xecus/opensource-mri-project/PCB/GradientCoil_transverse/Gradient_Coil v4.dxf

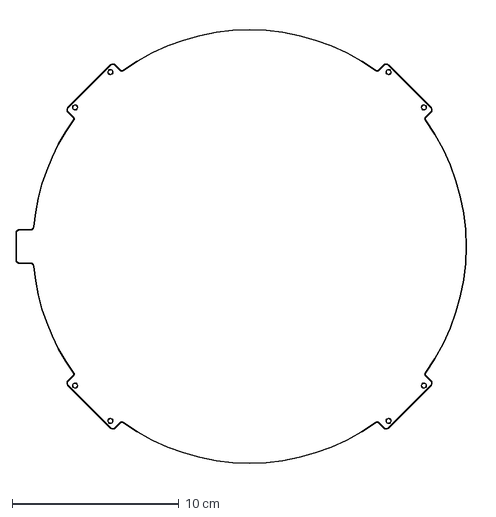
[picture p1: CAD file, 2020-04-10]
PCB/GradientCoil_transverse/Gradient_Coil v4.dxf
27.8 x 27.6 cm
