xecus/opensource-mri-project/PCB/GradientCoil_transverse/Gradient_Coil v3.dxf

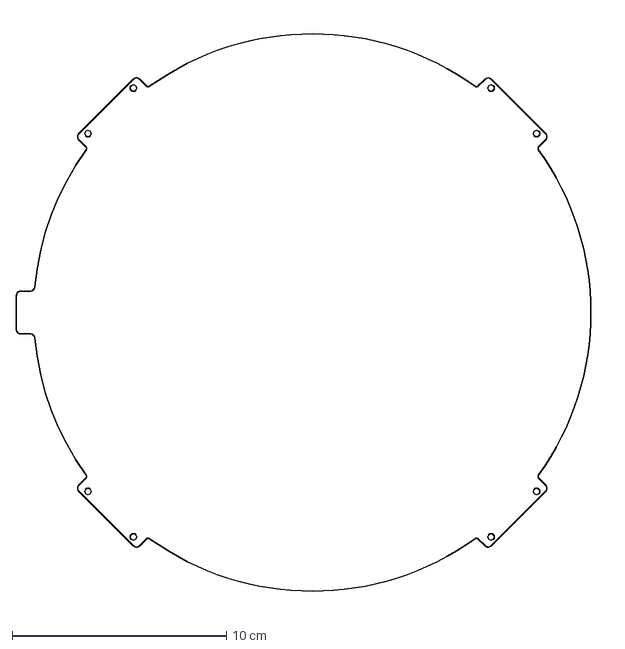
[picture p2: CAD file, 2020-04-10, an earlier design]
PCB/GradientCoil_transverse/Gradient_Coil v3.dxf
27.6 x 27.6 cm
