xecus/opensource-mri-project/(threads)

Thread 2 (2020-03-20):

MRIハードウェア課題

LDshiro, 2020-03-20:
- [ ] 勾配コイルドライバ
　・回路設計とシミュレーション（完了
　・基板設計と発注　（完了
　・部品実装　実施中(80%
　・回路動作検証方法の検討（0%
　・ドライバ回路筐体の設計  (0%

- [ ] メインコイル電流調整用ユニットの開発
   ・筐体の設計　(90%
   ・使用電源の選定と発注（完了
   ・回路設計とシミュレーション　(0%
　・基板設計と発注　（0%

Thread 3 (2020-03-20):

初期のディレクトリ構成の決定

xecus, 2020-03-20:
# WHY

下記、今後増えていく可能性のあるコードベース。
一旦、可能性ベースでまとめて初期のディレクトリ構成をキメる。

- Project Document
  - Portal Site

- Design Document
  - 設計思想等

- Hardware
  - 筐体(3Dプリンティングデータ)

- Software
  - HDL系
  - 制御系
  - 画像再構成系

- SImulations
  - 回路シミュレーション系
  - 物理シミュレーション系

xecus, 2020-03-20:
[FYI]

Project DocumentのPortal Siteは、下記で検討中。
https://github.com/xecus/opensource-mri-project/issues/1

Thread 4 (2020-03-20):

FPGAボードの開発

LDshiro, 2020-03-20:
要求仕様
 今の所は勘で仕様を決定
・16bit ADC 100MSpsのドライブ
・14bit DAC 100MSpsのドライブ
・リアルタイム性
・10M程度のメモリ（あとで詳細検討する

開発フロー
DE0+自作ADC/DACボードで動作検証
↓
FPGA+ADC/DAC搭載ボードの設計
↓
特性測定と基板設計へのフィードバック（1~2サイクル程度
↓
開発完了

Thread 6 (2020-03-30):

RF検出用アンプの開発

LDshiro, 2020-03-30:
##現状
現状で作成している検出アンプはゲイン50倍程度が限度であり、発振防止の為に共振回路に抵抗を直列に入れている。このために、抵抗の熱雑音等でSNRが下がる等の問題を抱えており、最適とは言えない。今回のプロジェクトでは、静磁場が10mTと低い為、検出系に関しては理論値に迫る最適設計が不可欠である。
