xecus/opensource-mri-project/PCB/GradientDriver_rev2/GradientDriver.kicad_pcb

## KiCad design PCB/GradientDriver_rev2/GradientDriver.kicad_pcb (2020-05-16)

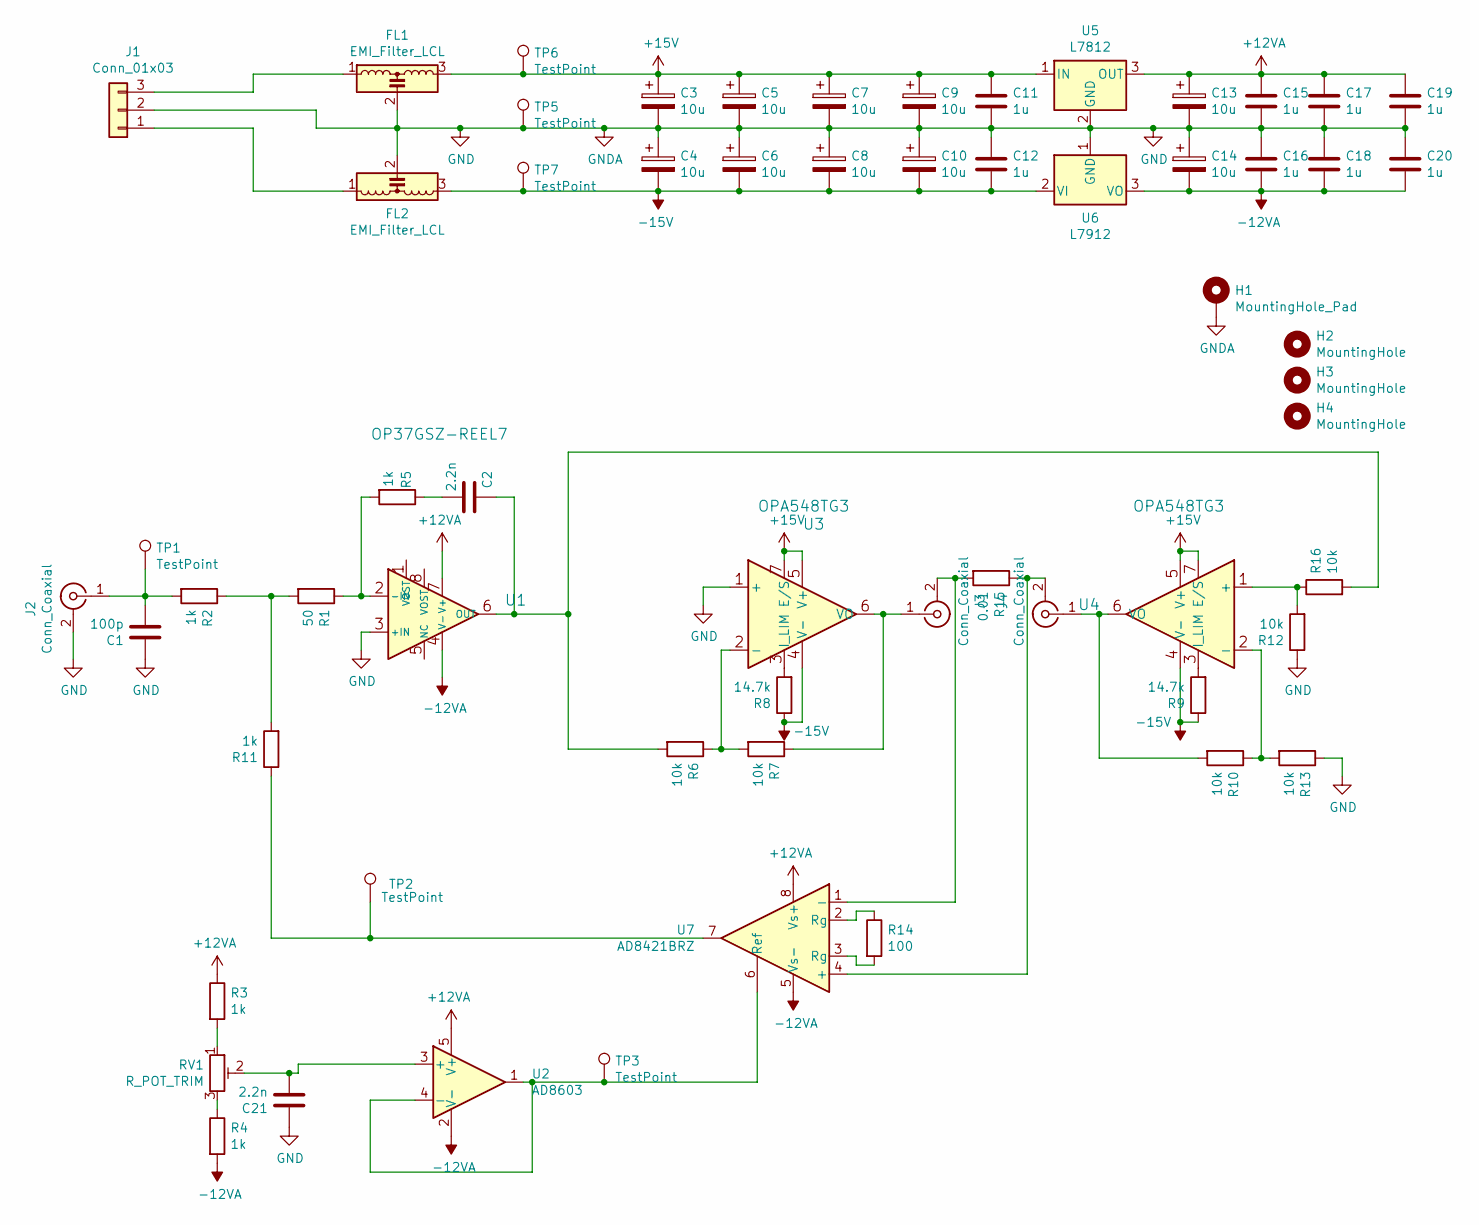
[picture p3: schematic GradientDriver.sch]

Parts:
C1: 100p; C_0603_1608Metric_Pad1.05x0.95mm_HandSolder
C2, C21: 2.2n; C_0603_1608Metric_Pad1.05x0.95mm_HandSolder
C3, C4, C5, C6, C7, C8, C9, C10, C13, C14: 10u; C_Elec_5x5.8
C11, C12, C15, C16, C17, C18, C19, C20: 1u; C_0603_1608Metric_Pad1.05x0.95mm_HandSolder
FL1, FL2: EMI_Filter_LCL; EMI_Filter_2606
H1: MountingHole_Pad; MountingHole_3.2mm_M3_Pad_Via
H2, H3, H4: MountingHole; MountingHole_3.2mm_M3_Pad_Via
J1: Conn_01x03; JST_XH_S3B-XH-A-1_1x03_P2.50mm_Horizontal
J2, J3, J4: Conn_Coaxial; SMA_Samtec_SMA-J-P-X-ST-EM1_EdgeMount
R1: 50; R_0603_1608Metric_Pad1.05x0.95mm_HandSolder
R2, R3, R4, R5, R11: 1k; R_0603_1608Metric_Pad1.05x0.95mm_HandSolder
R6, R7, R10, R12, R13, R16: 10k; R_0603_1608Metric_Pad1.05x0.95mm_HandSolder
R8, R9: 14.7k; R_0603_1608Metric_Pad1.05x0.95mm_HandSolder
R14: 100; R_0603_1608Metric_Pad1.05x0.95mm_HandSolder
R15: 0.01; R_2512_6332Metric_Pad1.52x3.35mm_HandSolder
RV1: R_POT_TRIM; Potentiometer_Bourns_3269W_Vertical
TP1, TP2, TP3, TP5, TP6, TP7: TestPoint; HK-1-G
U1: OP37GSZ-REEL7; SSOP-8_3.9x5.05mm_P1.27mm
U2: AD8603; TSOT-23-5
U3, U4: OPA548TG3
U5: L7812; TO-252-3_TabPin4
U6: L7912; TO-252-3_TabPin4
U7: AD8421BRZ; SOIC-8-1EP_3.9x4.9mm_P1.27mm_EP2.29x3mm

Connections:
+12VA: C13.1, C15.1, C17.1, C19.1, R3.1, U1.7 (V+), U2.5 (V+), U5.3 (OUT), U7.8 (Vs+)
+15V: C3.1, C5.1, C7.1, C9.1, C11.1, FL1.3, TP6.1, U3.5 (V+), U3.7 (E/S), U4.5 (V+), U4.7 (E/S), U5.1 (IN)
-12VA: C14.2, C16.2, C18.2, C20.2, R4.2, U1.4 (V-), U2.2 (V-), U6.3 (VO), U7.5 (Vs-)
-15V: C4.2, C6.2, C8.2, C10.2, C12.2, FL2.3, R8.1, R9.1, TP7.1, U3.4 (V-), U4.4 (V-), U6.2 (VI), U6.4
GND: C1.1, C3.2, C4.1, C5.2, C6.1, C7.2, C8.1, C9.2, C10.1, C11.2, C12.1, C13.2, C14.1, C15.2, C16.1, C17.2, C18.1, C19.2, C20.1, C21.1, FL1.2, FL2.2, H1.1, J1.2, J2.2 (Ext), R12.1, R13.1, TP5.1, U1.3 (+IN), U3.1 (+), U5.2 (GND), U6.1 (GND)
unnamed: C1.2, J2.1 (In), R2.2, TP1.1
unnamed: C2.1, R6.2, R16.2, U1.6 (OUT)
unnamed: C2.2, R5.1
unnamed: C21.2, RV1.2, U2.3 (+)
unnamed: FL1.1, J1.3
unnamed: FL2.1, J1.1
unnamed: J3.1 (In), R7.1, U3.6 (VO)
unnamed: J3.2 (Ext), R15.2, U7.1 (-)
unnamed: J4.1 (In), R10.2, U4.6 (VO)
unnamed: J4.2 (Ext), R15.1, U7.4 (+)
unnamed: R1.1, R5.2, U1.2 (-IN)
unnamed: R1.2, R2.1, R11.2
unnamed: R3.2, RV1.1
unnamed: R4.1, RV1.3
unnamed: R6.1, R7.2, U3.2 (-)
unnamed: R8.2, U3.3 (I_LIM)
unnamed: R9.2, U4.3 (I_LIM)
unnamed: R10.1, R13.2, U4.2 (-)
unnamed: R11.1, TP2.1, U7.7
unnamed: R12.2, R16.1, U4.1 (+)
unnamed: R14.1, U7.2 (Rg)
unnamed: R14.2, U7.3 (Rg)
unnamed: TP3.1, U2.1, U2.4 (-), U7.6 (Ref)

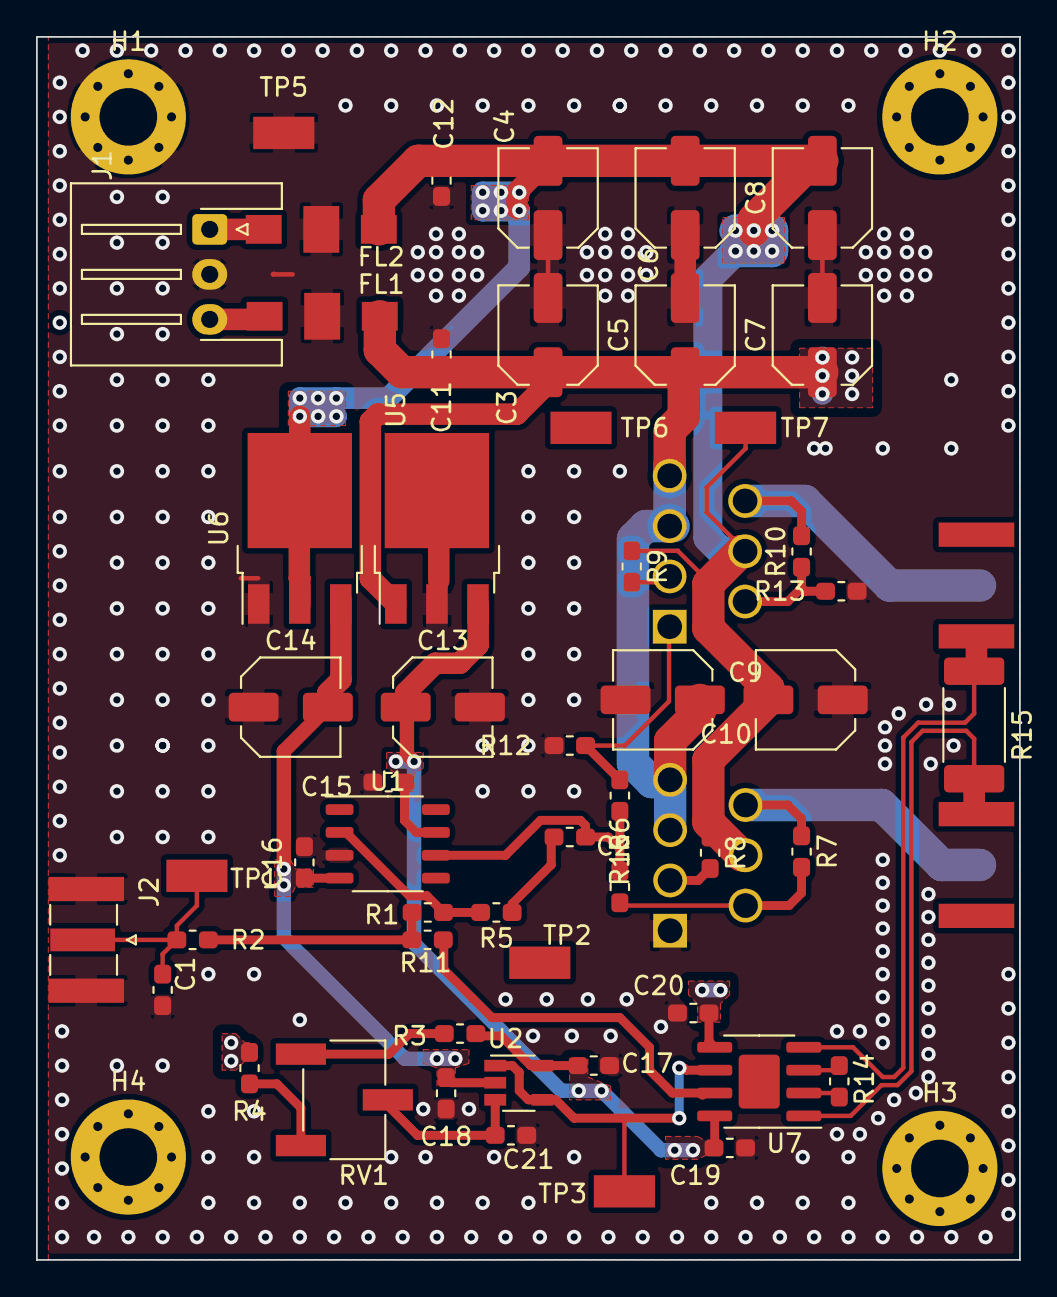
[picture p4: board PCB/GradientDriver_rev2/GradientDriver.kicad_pcb from above]

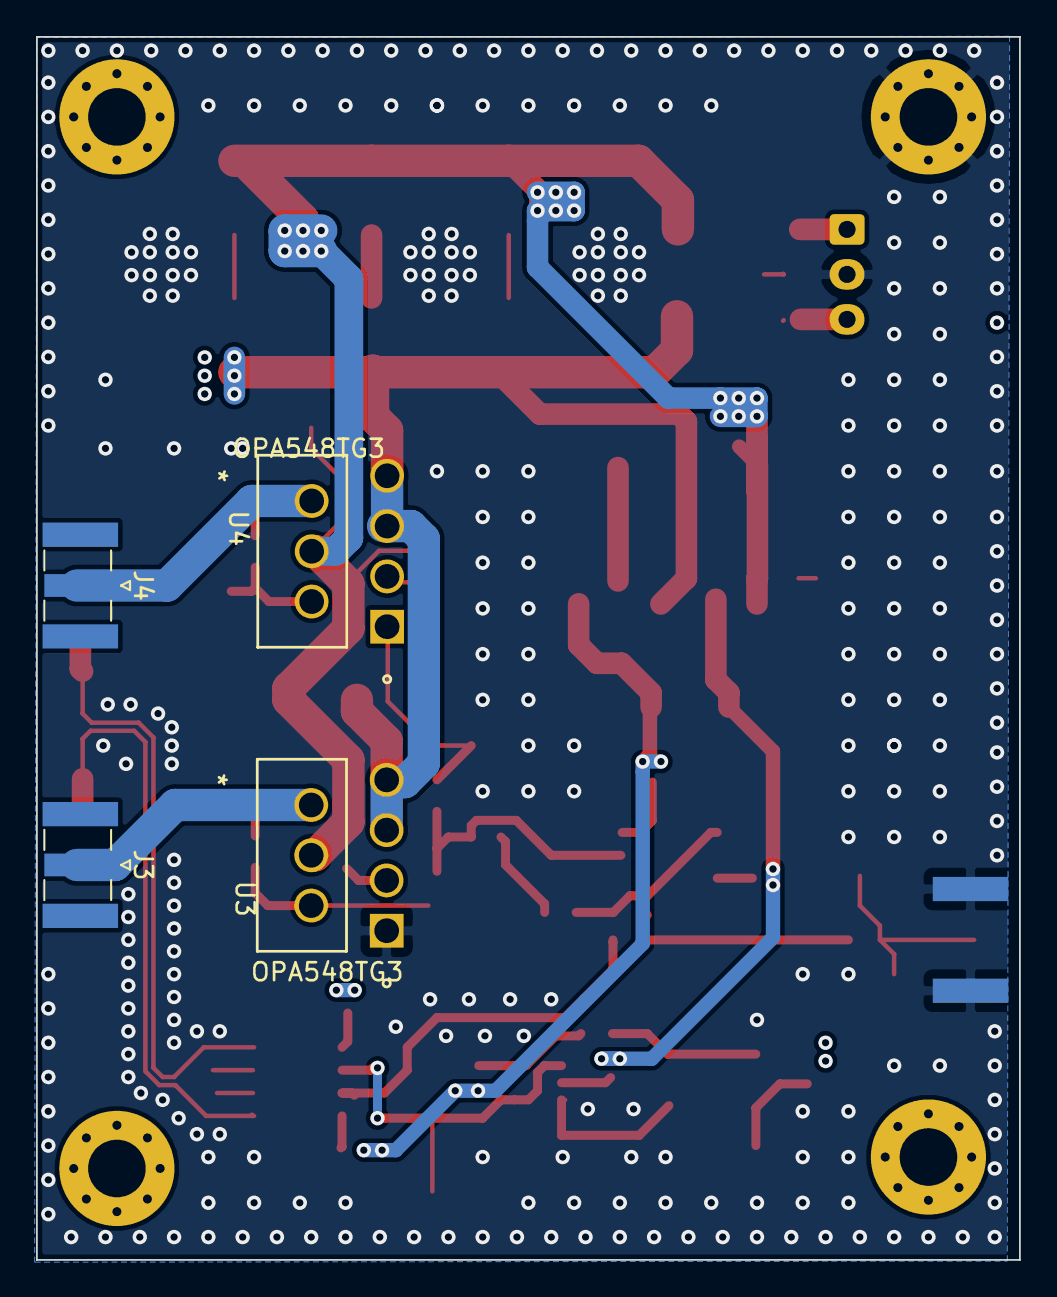
[picture p5: board PCB/GradientDriver_rev2/GradientDriver.kicad_pcb from below]

Board: 4 copper layers, 54.6 x 67.9 mm, 61 parts (4 on the bottom side), 28 nets.
