xecus/opensource-mri-project/PCB/GradientDriver/GradientDriver.kicad_pcb

## KiCad design PCB/GradientDriver/GradientDriver.kicad_pcb (2020-05-16, an earlier design)

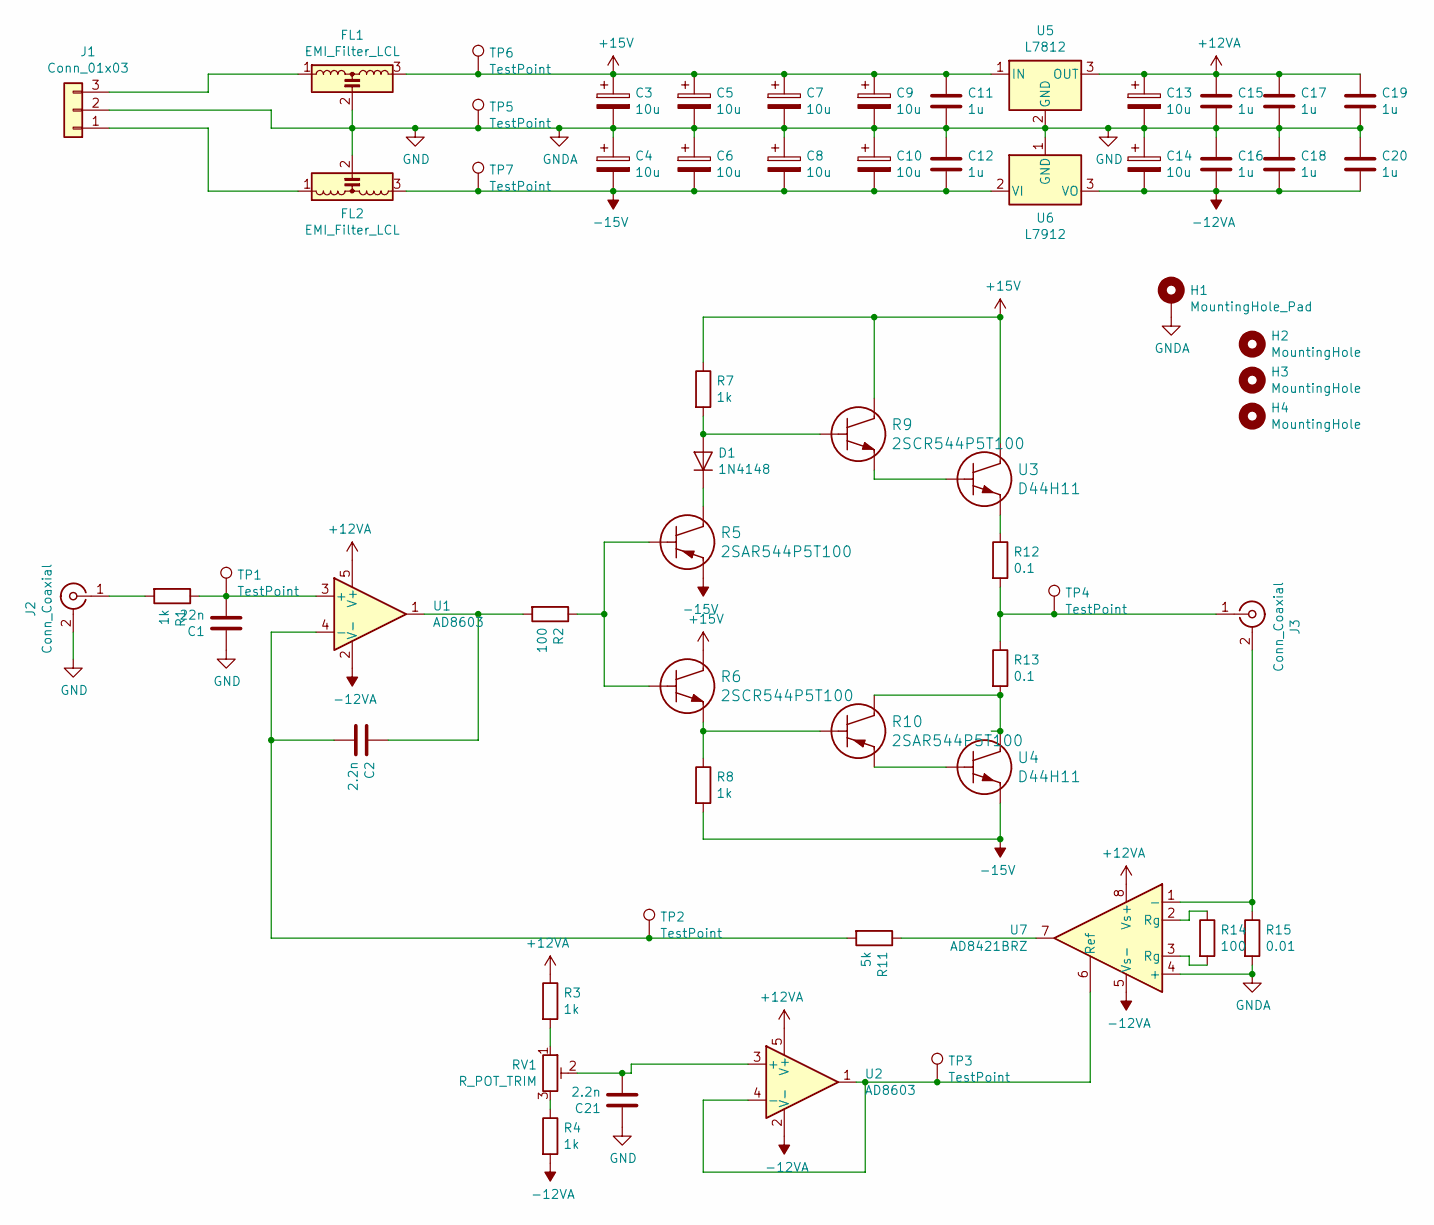
[picture p6: schematic GradientDriver.sch]

Parts:
C1: 22n; C_0603_1608Metric_Pad1.05x0.95mm_HandSolder
C2, C21: 2.2n; C_0603_1608Metric_Pad1.05x0.95mm_HandSolder
C3, C4, C5, C6, C7, C8, C9, C10, C13, C14: 10u; C_Elec_5x5.8
C11, C12, C15, C16, C17, C18, C19, C20: 1u; C_0603_1608Metric_Pad1.05x0.95mm_HandSolder
D1: 1N4148; D_SOD-323_HandSoldering
FL1, FL2: EMI_Filter_LCL; EMI_Filter_2606
H1: MountingHole_Pad; MountingHole_3.2mm_M3_Pad_Via
H2, H3, H4: MountingHole; MountingHole_3.2mm_M3_Pad_Via
J1: Conn_01x03; JST_XH_S3B-XH-A-1_1x03_P2.50mm_Horizontal
J2, J3: Conn_Coaxial; SMA_Samtec_SMA-J-P-X-ST-EM1_EdgeMount
R1, R3, R4, R7, R8: 1k; R_0603_1608Metric_Pad1.05x0.95mm_HandSolder
R2, R14: 100; R_0603_1608Metric_Pad1.05x0.95mm_HandSolder
R5, R10: 2SAR544P5T100; SOT-89-3_Handsoldering
R6, R9: 2SCR544P5T100; SOT-89-3_Handsoldering
R11: 5k; R_0603_1608Metric_Pad1.05x0.95mm_HandSolder
R12, R13: 0.1; TLRH3APTTER100F
R15: 0.01; R_2512_6332Metric_Pad1.52x3.35mm_HandSolder
RV1: R_POT_TRIM; Potentiometer_Bourns_3269W_Vertical
TP1, TP2, TP3, TP4, TP5, TP6, TP7: TestPoint; HK-1-G
U1, U2: AD8603; TSOT-23-5
U3, U4: D44H11
U5: L7812; TO-252-3_TabPin4
U6: L7912; TO-252-3_TabPin4
U7: AD8421BRZ; SOIC-8-1EP_3.9x4.9mm_P1.27mm_EP2.29x3mm

Connections:
+12VA: C13.1, C15.1, C17.1, C19.1, R3.1, U1.5 (V+), U2.5 (V+), U5.3 (OUT), U7.8 (Vs+)
+15V: C3.1, C5.1, C7.1, C9.1, C11.1, FL1.3, R6.2, R7.1, R9.2, TP6.1, U3.2 (C), U5.1 (IN)
-12VA: C14.2, C16.2, C18.2, C20.2, R4.2, U1.2 (V-), U2.2 (V-), U6.3 (VO), U7.5 (Vs-)
-15V: C4.2, C6.2, C8.2, C10.2, C12.2, FL2.3, R5.3, R8.2, TP7.1, U4.3 (E), U6.2 (VI), U6.4
GND: C1.1, C3.2, C4.1, C5.2, C6.1, C7.2, C8.1, C9.2, C10.1, C11.2, C12.1, C13.2, C14.1, C15.2, C16.1, C17.2, C18.1, C19.2, C20.1, C21.1, FL1.2, FL2.2, H1.1, J1.2, J2.2 (Ext), R15.2, TP5.1, U5.2 (GND), U5.4, U6.1 (GND), U7.4 (+)
unnamed: C1.2, R1.1, TP1.1, U1.3 (+)
unnamed: C2.1, R2.2, U1.1
unnamed: C2.2, R11.2, TP2.1, U1.4 (-)
unnamed: C21.2, RV1.2, U2.3 (+)
unnamed: D1.1 (K), R5.2
unnamed: D1.2 (A), R7.2, R9.1
unnamed: FL1.1, J1.3
unnamed: FL2.1, J1.1
unnamed: J2.1 (In), R1.2
unnamed: J3.1 (In), R12.2, R13.1, TP4.1
unnamed: J3.2 (Ext), R15.1, U7.1 (-)
unnamed: R2.1, R5.1, R6.1
unnamed: R3.2, RV1.1
unnamed: R4.1, RV1.3
unnamed: R9.3, U3.1 (B)
unnamed: R6.3, R8.1, R10.1
unnamed: R10.2, R13.2, U4.2 (C)
unnamed: R10.3, U4.1 (B)
unnamed: R11.1, U7.7
unnamed: R12.1, U3.3 (E)
unnamed: R14.1, U7.2 (Rg)
unnamed: R14.2, U7.3 (Rg)
unnamed: TP3.1, U2.1, U2.4 (-), U7.6 (Ref)

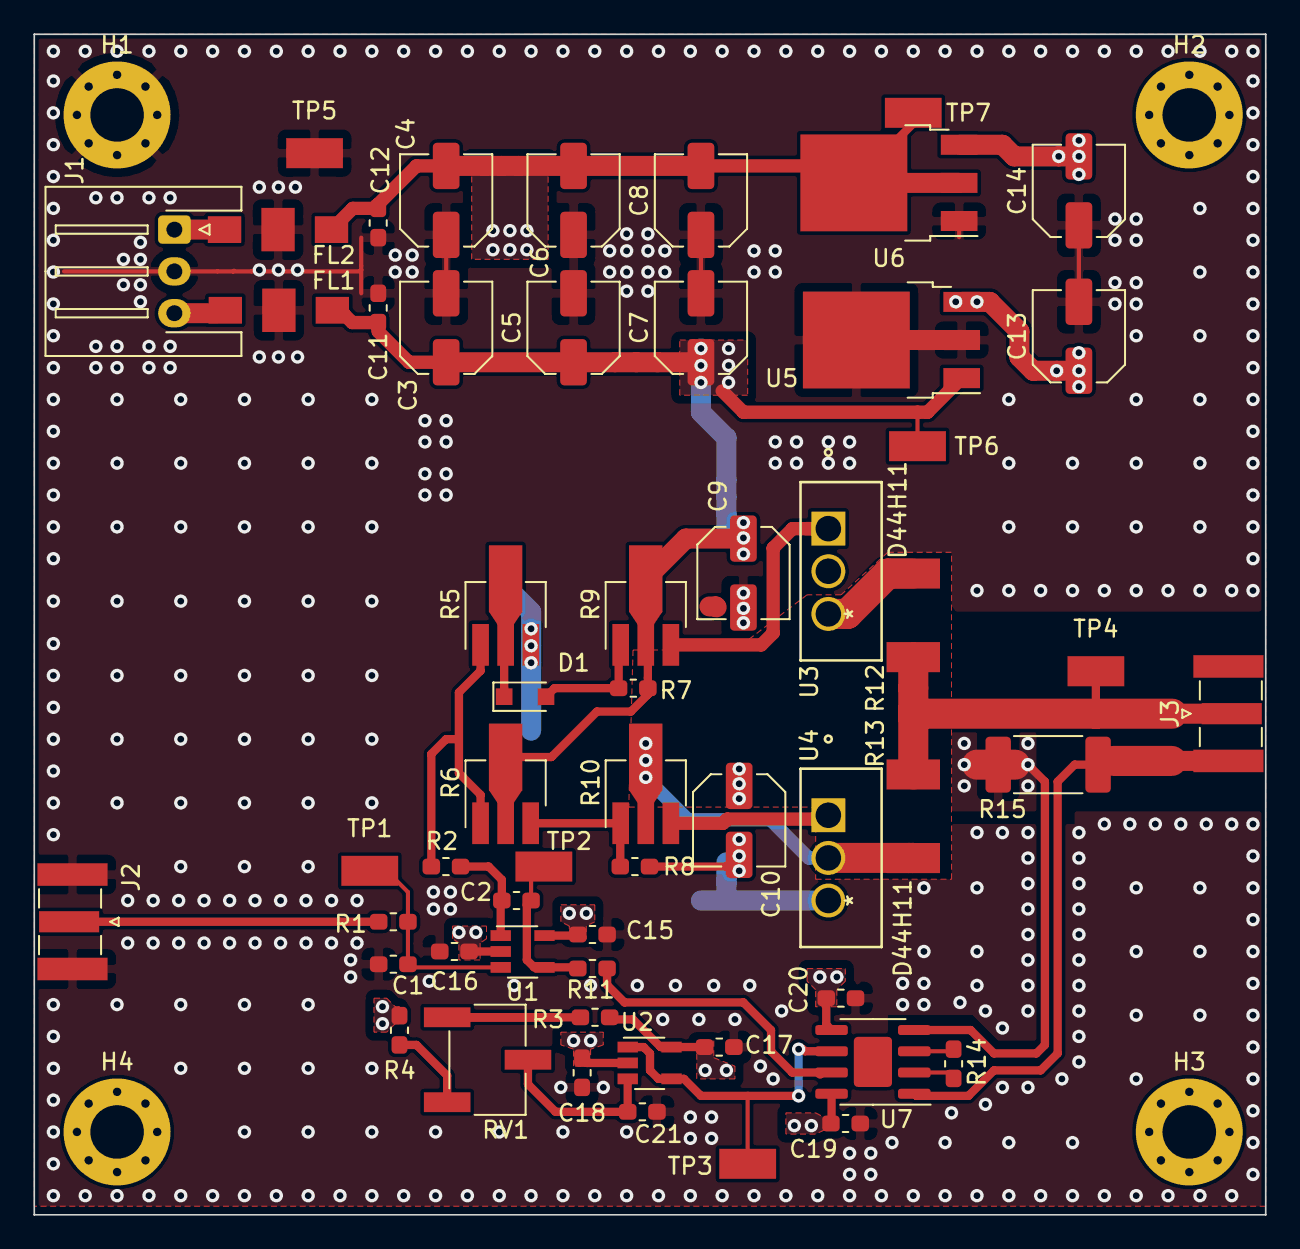
[picture p7: board PCB/GradientDriver/GradientDriver.kicad_pcb from above]

Board: 4 copper layers, 73.7 x 70.6 mm, 61 parts (0 on the bottom side), 28 nets.
