xecus/opensource-mri-project/PCB/Current_Controller/Current_Controller.kicad_pcb

## KiCad design PCB/Current_Controller/Current_Controller.kicad_pcb (2020-05-16)

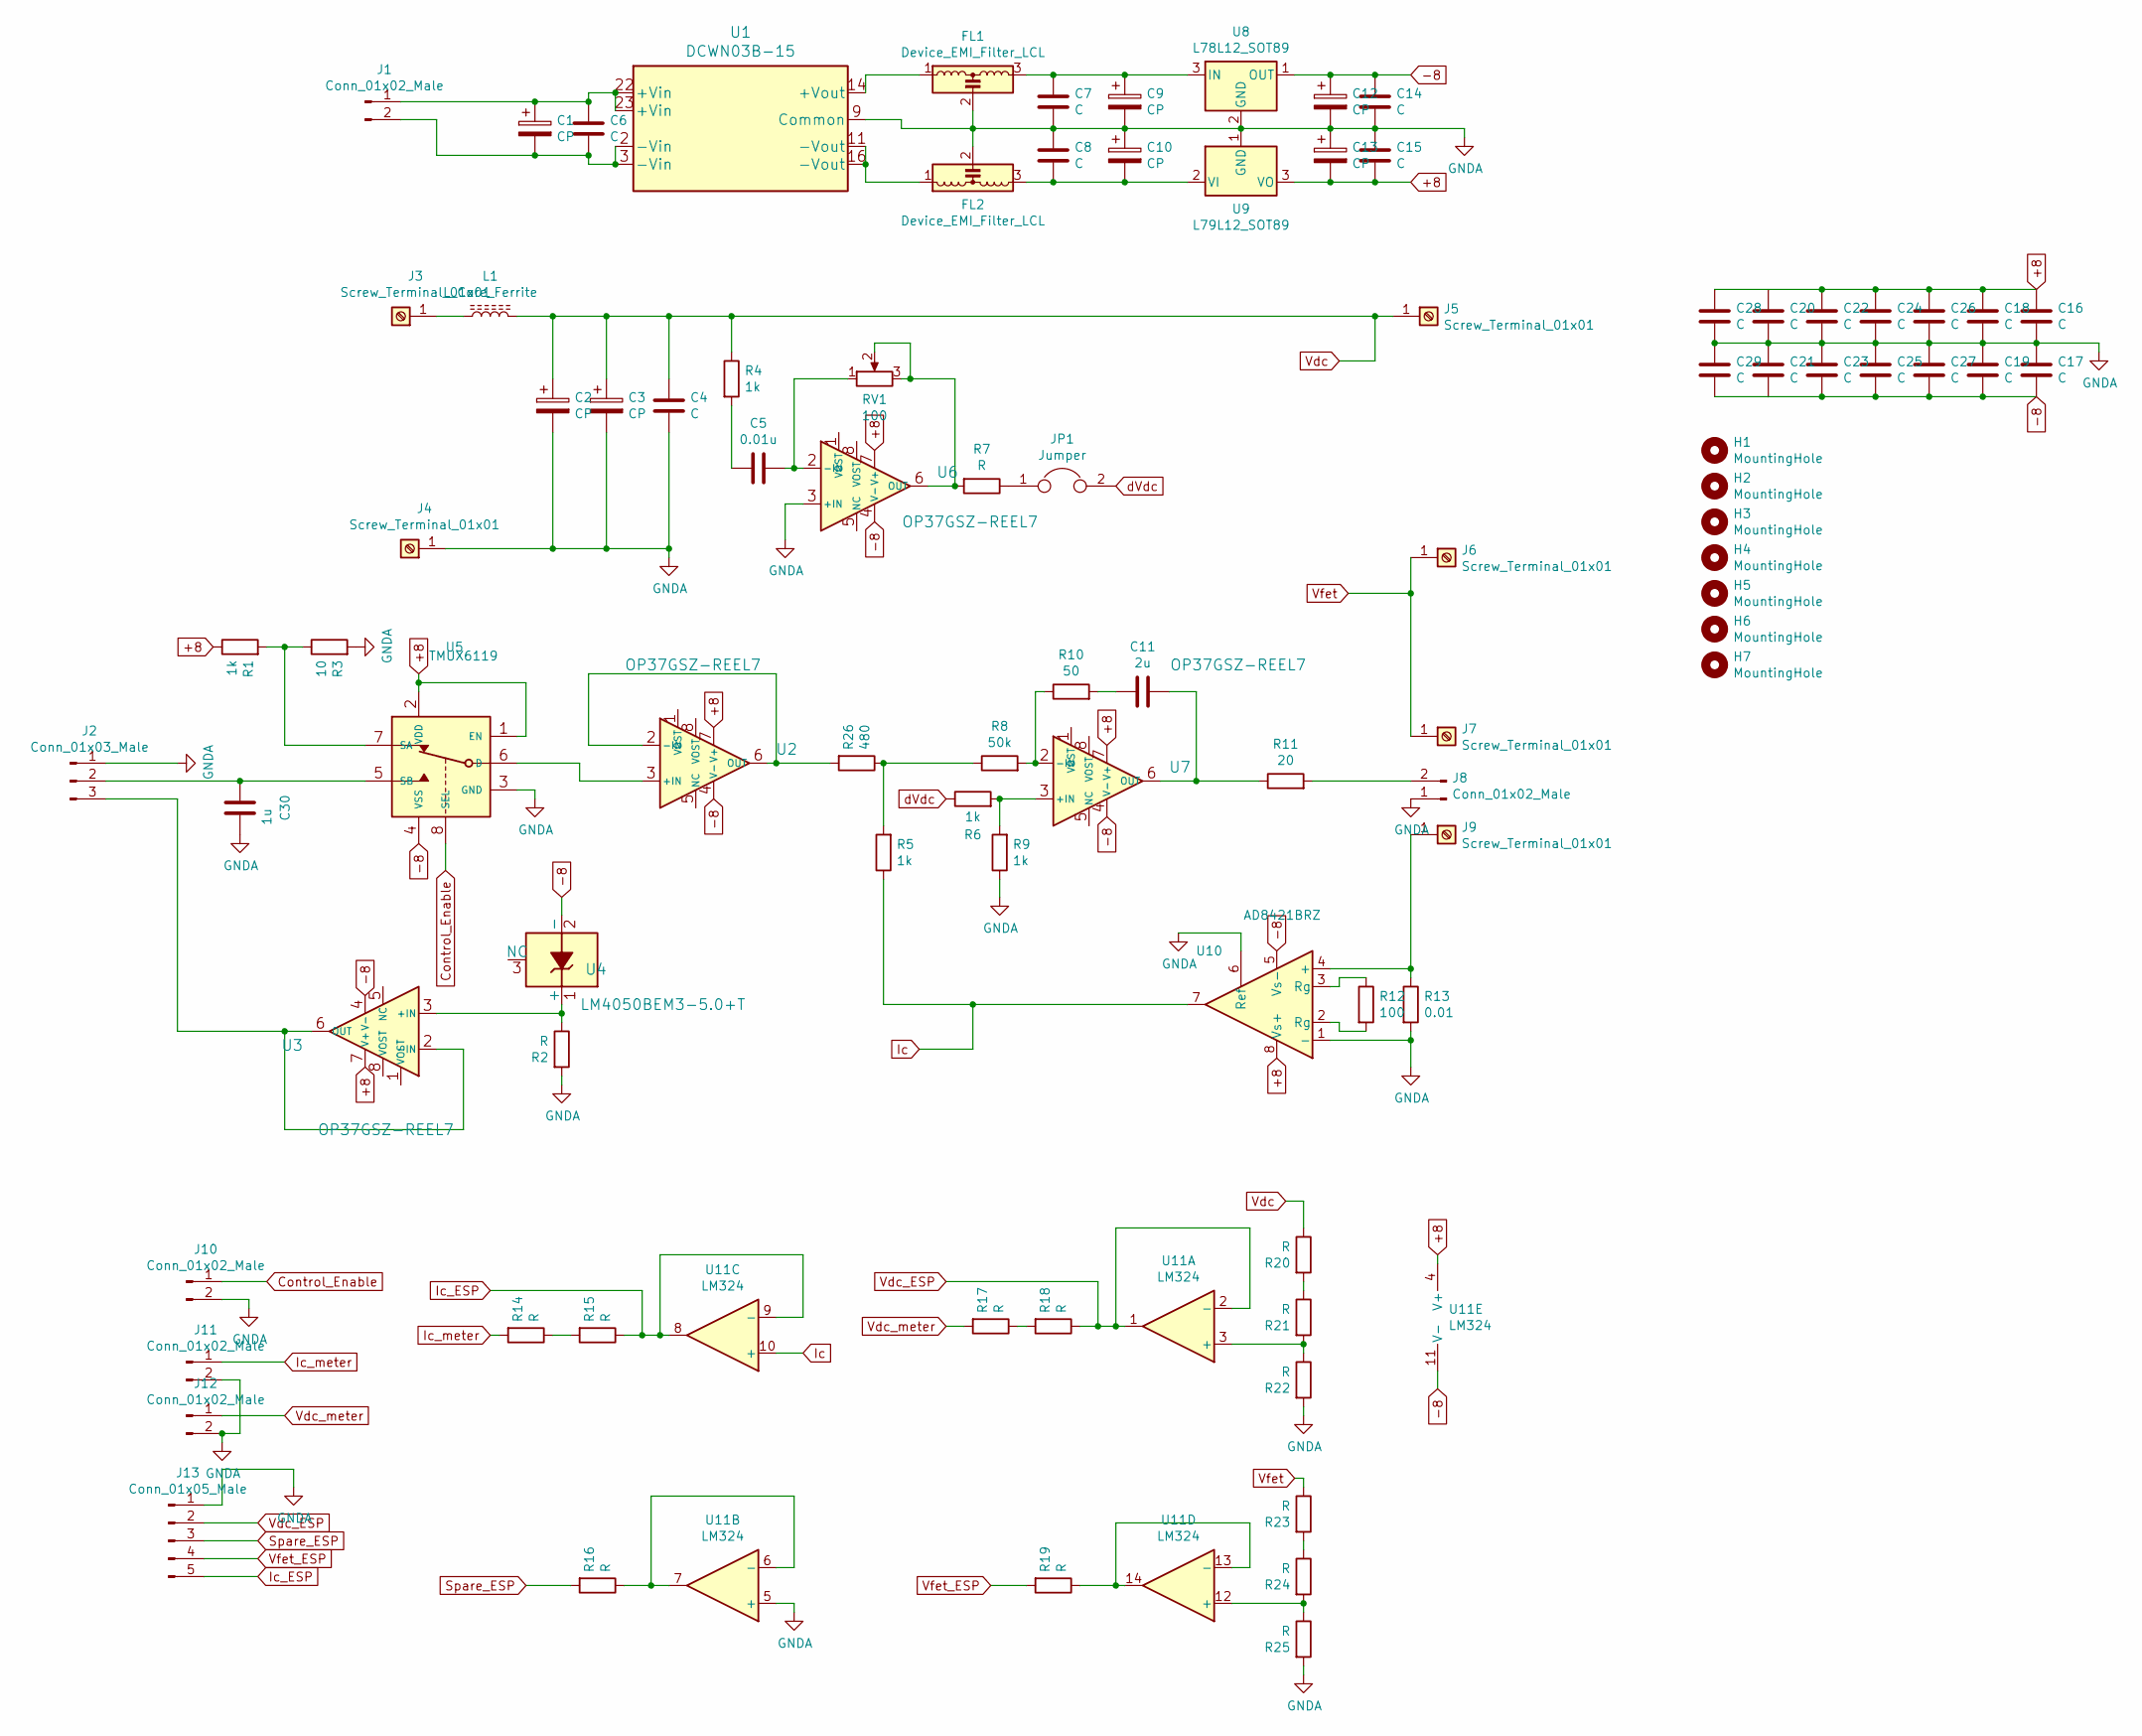
[picture p8: schematic Current_Controller.sch]

Parts:
C1, C9, C10, C12, C13: CP; CP_Elec_5x5.8
C2, C3: CP; CP_Radial_D30.0mm_P10.00mm_SnapIn
C4: C; C_Rect_L10.3mm_W5.7mm_P7.50mm_MKS4
C5: 0.01u; C_0603_1608Metric
C6, C7, C8, C14, C15, C16, C17, C18, C19, C20, C21, C22, C23, C24, C25, C26, C27, C28, C29: C; C_0603_1608Metric
C11: 2u; C_0603_1608Metric
C30: 1u; C_0603_1608Metric
FL1, FL2: Device_EMI_Filter_LCL; EMI_Filter_2606
H1, H2, H3, H4, H5, H6, H7: MountingHole; MountingHole_3.2mm_M3_Pad_Via
J1, J8, J10, J11, J12: Conn_01x02_Male; JST_XH_B2B-XH-AM_1x02_P2.50mm_Vertical
J2: Conn_01x03_Male; JST_XH_B3B-XH-AM_1x03_P2.50mm_Vertical
J3, J4, J5, J6, J7, J9: Screw_Terminal_01x01; keystone_7698
J13: Conn_01x05_Male; JST_XH_B5B-XH-AM_1x05_P2.50mm_Vertical
JP1: Jumper; PinHeader_1x02_P2.54mm_Vertical
L1: L_Core_Ferrite; L_250uH2
R1, R4, R5, R6, R9: 1k; R_0603_1608Metric
R2, R7, R14, R15, R16, R17, R18, R19, R20, R21, R22, R23, R24, R25: R; R_0603_1608Metric
R3: 10; R_0603_1608Metric
R8: 50k; R_0603_1608Metric
R10: 50; R_0603_1608Metric
R11: 20; R_0603_1608Metric
R12: 100; R_0603_1608Metric
R13: 0.01; GMR100HTBFA10L0
R26: 480; R_0603_1608Metric
RV1: 100; Potentiometer_Bourns_3269W_Vertical
U1: DCWN03B-15; DCWN03B-12
U2, U3, U6, U7: OP37GSZ-REEL7; SOIC-8_3.9x4.9mm_P1.27mm
U4: LM4050BEM3-5.0+T; LM4050QBEM3-8.2&slash_NOPB
U5: TMUX6119; SOT-23-8
U8: L78L12_SOT89; SOT-89-3
U9: L79L12_SOT89; SOT-89-3
U10: AD8421BRZ; SOIC-8_3.9x4.9mm_P1.27mm
U11: LM324; TSSOP-14_4.4x5mm_P0.65mm

Connections:
+8: C13.2, C15.1, C16.2, C18.2, C20.2, C22.2, C24.2, C26.2, C28.2, R1.1, U2.7 (V+), U3.7 (V+), U5.1 (EN), U5.2 (VDD), U6.7 (V+), U7.7 (V+), U9.3 (VO), U10.8 (Vs+), U11.4 (V+)
-8: C12.1, C14.2, C17.1, C19.1, C21.1, C23.1, C25.1, C27.1, C29.1, U2.4 (V-), U3.4 (V-), U4.2 (-), U5.4 (VSS), U6.4 (V-), U7.4 (V-), U8.1 (OUT), U10.5 (Vs-), U11.11 (V-)
Control_Enable: J10.1, U5.8 (SEL)
GNDA: C2.2, C3.2, C4.1, C7.1, C8.2, C9.2, C10.1, C12.2, C13.1, C14.1, C15.2, C16.1, C17.2, C18.1, C19.2, C20.1, C21.2, C22.1, C23.2, C24.1, C25.2, C26.1, C27.2, C28.1, C29.2, C30.1, FL1.2, FL2.2, J2.1, J4.1, J8.1, J10.2, J11.2, J12.2, J13.1, R2.2, R3.2, R9.1, R13.2, R22.2, R25.2, U1.9 (Common), U5.3 (GND), U6.3 (+IN), U8.2 (GND), U9.1 (GND), U10.1 (-), U10.6 (Ref), U11.5 (+)
Ic: R5.1, U10.7, U11.10 (+)
Ic_ESP: J13.5, R15.1, U11.8, U11.9 (-)
Ic_meter: J11.1, R14.2
unnamed: C1.1, C6.2, J1.1, U1.22 (+Vin), U1.23 (+Vin)
unnamed: C1.2, C6.1, J1.2, U1.2 (-Vin), U1.3 (-Vin)
unnamed: C5.1, RV1.1, U6.2 (-IN)
unnamed: C5.2, R4.2
unnamed: C7.2, C9.1, FL1.3, U8.3 (IN)
unnamed: C8.1, C10.2, FL2.3, U9.2 (VI)
unnamed: C11.1, R11.1, U7.6 (OUT)
unnamed: C11.2, R10.2
unnamed: C30.2, J2.2, U5.5 (SB)
unnamed: FL1.1, U1.14 (+Vout)
unnamed: FL2.1, U1.11 (-Vout), U1.16 (-Vout)
unnamed: J2.3, U3.2 (-IN), U3.6 (OUT)
unnamed: J3.1, L1.1
unnamed: J8.2, R11.2
unnamed: J9.1, R13.1, U10.4 (+)
unnamed: JP1.1, R7.1
unnamed: R1.2, R3.1, U5.7 (SA)
unnamed: R2.1, U3.3 (+IN), U4.1 (+)
unnamed: R6.2, R9.2, U7.3 (+IN)
unnamed: R7.2, RV1.2, RV1.3, U6.6 (OUT)
unnamed: R8.2, R10.1, U7.2 (-IN)
unnamed: R12.1, U10.3 (Rg)
unnamed: R12.2, U10.2 (Rg)
unnamed: R14.1, R15.2
unnamed: R16.1, U11.6 (-), U11.7
unnamed: R17.1, R18.2
unnamed: R19.1, U11.13 (-), U11.14
unnamed: R20.2, R21.1
unnamed: R21.2, R22.1, U11.3 (+)
unnamed: R23.2, R24.1
unnamed: R24.2, R25.1, U11.12 (+)
unnamed: R5.2, R8.1, R26.1
unnamed: R26.2, U2.2 (-IN), U2.6 (OUT)
unnamed: U2.3 (+IN), U5.6 (D)
Spare_ESP: J13.3, R16.2
Vdc: C2.1, C3.1, C4.2, J5.1, L1.2, R4.1, R20.1
Vdc_ESP: J13.2, R18.1, U11.1, U11.2 (-)
Vdc_meter: J12.1, R17.2
Vfet: J6.1, J7.1, R23.1
Vfet_ESP: J13.4, R19.2
dVdc: JP1.2, R6.1

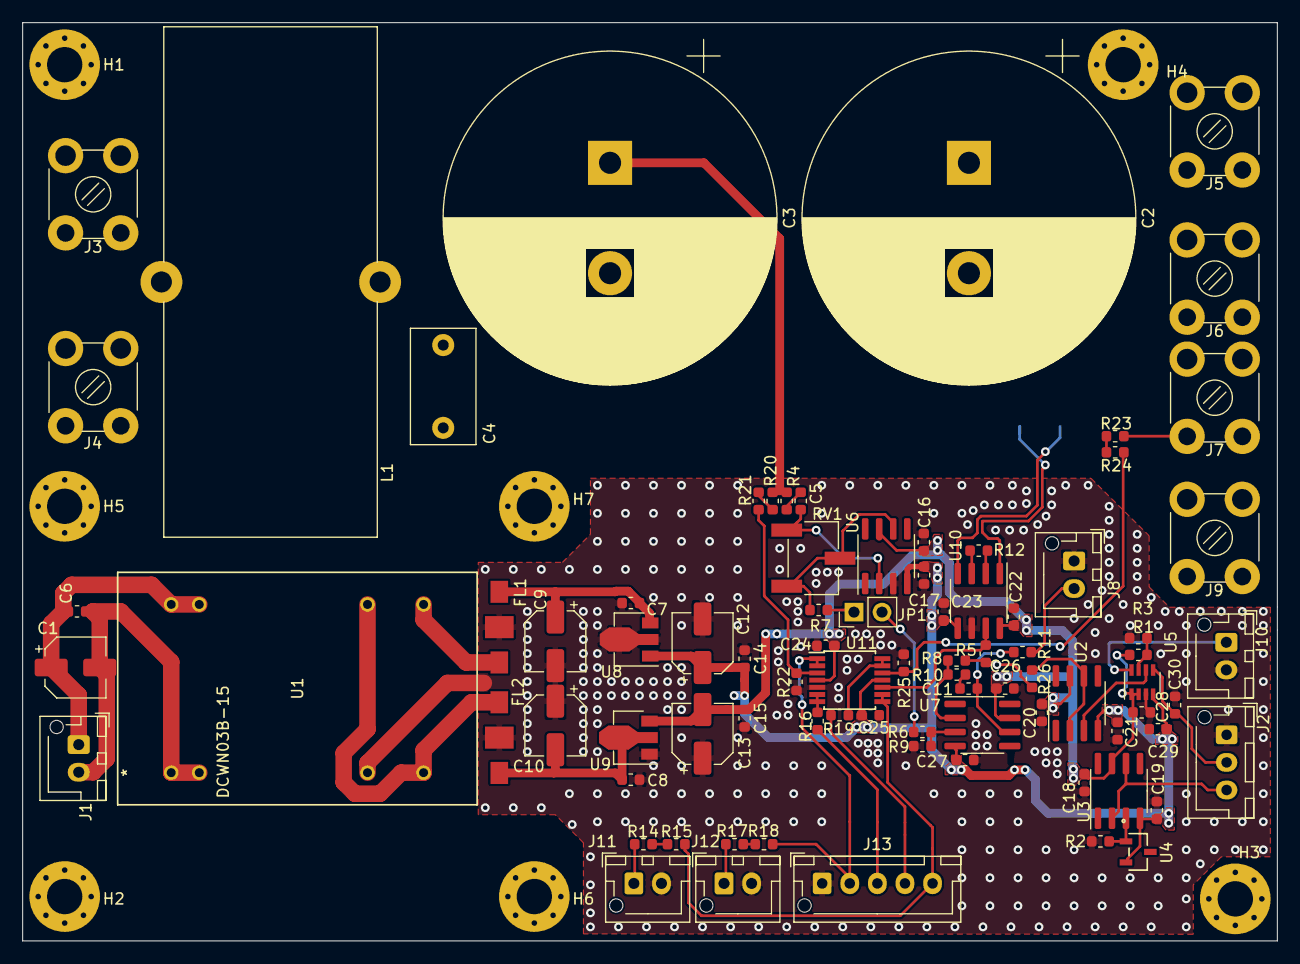
[picture p9: board Current_Controller.kicad_pcb from above]

Board: 2 copper layers, 113.7 x 83.2 mm, 92 parts (1 on the bottom side), 48 nets.
