xecus/opensource-mri-project/PCB/FPGA_sequencer/FPGA_sequencer.kicad_pcb

## KiCad design PCB/FPGA_sequencer/FPGA_sequencer.kicad_pcb (2020-05-16)

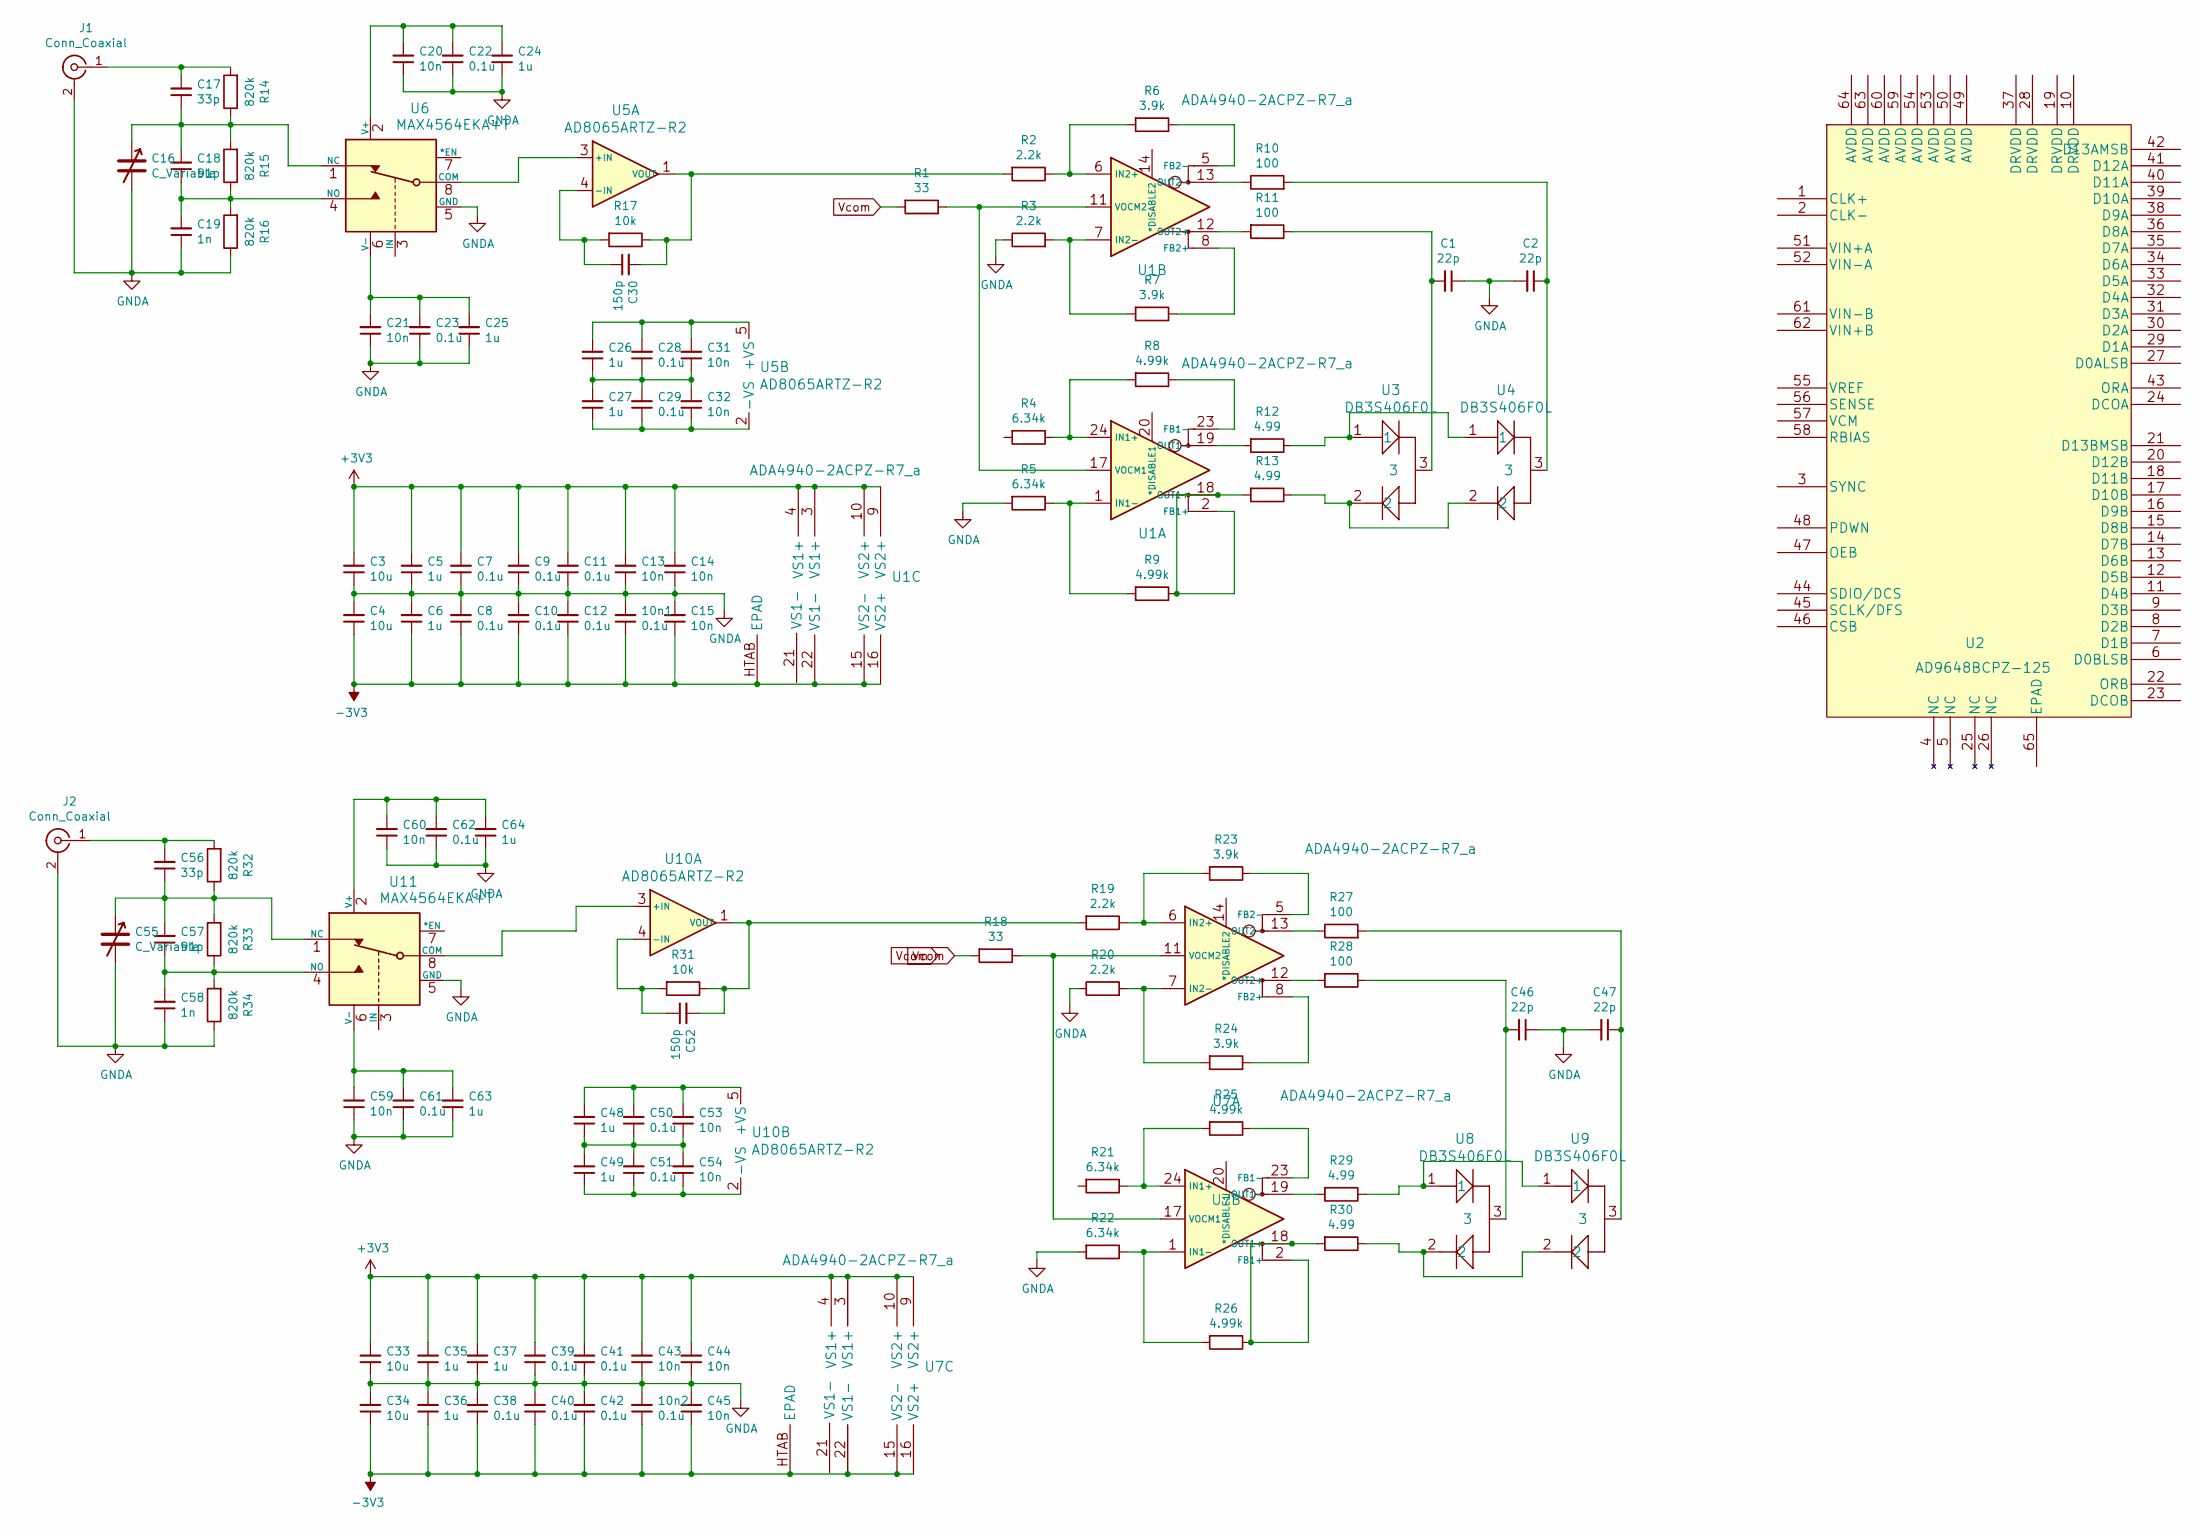
[picture p10: schematic FPGA_sequencer.sch]

Parts:
10n1, 10n2: 0.1u; C_0402_1005Metric
C1, C2, C46, C47: 22p; C_0402_1005Metric
C3, C4, C33, C34: 10u; C_0402_1005Metric
C5, C6, C24, C25, C26, C27, C35, C36, C37, C48, C49, C63, C64: 1u; C_0402_1005Metric
C7, C8, C9, C10, C11, C12, C22, C23, C28, C29, C38, C39, C40, C41, C42, C50, C51, C61, C62: 0.1u; C_0402_1005Metric
C13, C14, C15, C20, C21, C31, C32, C43, C44, C45, C53, C54, C59, C60: 10n; C_0402_1005Metric
C16, C55: C_Variable; C_Trimmer_Murata_TZB4-A
C17, C56: 33p; C_0402_1005Metric
C18, C57: 91p; C_0402_1005Metric
C19, C58: 1n; C_0402_1005Metric
C30, C52: 150p; C_0402_1005Metric
J1, J2: Conn_Coaxial; SMA_Amphenol_132134-11_Vertical
R1, R18: 33; R_0402_1005Metric
R2, R3, R19, R20: 2.2k; R_0402_1005Metric
R4, R5, R21, R22: 6.34k; R_0402_1005Metric
R6, R7, R23, R24: 3.9k; R_0402_1005Metric
R8, R9, R25, R26: 4.99k; R_0402_1005Metric
R10, R11, R27, R28: 100; R_0402_1005Metric
R12, R13, R29, R30: 4.99; R_0402_1005Metric
R14, R15, R16, R32, R33, R34: 820k; R_0402_1005Metric
R17, R31: 10k; R_0402_1005Metric
U1, U7: ADA4940-2ACPZ-R7_a; ADA4940-2ACPZ-R7
U2: AD9648BCPZ-125
U3, U4, U8, U9: DB3S406F0L
U5, U10: AD8065ARTZ-R2
U6, U11: MAX4564EKA+T; MAX4564EKA&plus_T

Connections:
+3V3: C3.2, C5.2, C7.2, C9.2, C11.2, C13.2, C14.2, C33.2, C35.2, C37.2, C39.2, C41.2, C43.2, C44.2, U1.3 (VS1+), U1.4 (VS1+), U1.9 (VS2+), U1.10 (VS2+), U7.3 (VS1+), U7.4 (VS1+), U7.9 (VS2+), U7.10 (VS2+)
-3V3: 10n1.1, 10n2.1, C4.1, C6.1, C8.1, C10.1, C12.1, C15.1, C34.1, C36.1, C38.1, C40.1, C42.1, C45.1, U1.15 (VS2-), U1.16 (VS2+), U1.22 (VS1-), U1.HTAB (EPAD), U7.15 (VS2-), U7.16 (VS2+), U7.22 (VS1-), U7.HTAB (EPAD)
GNDA: 10n1.2, 10n2.2, C1.1, C2.2, C3.1, C4.2, C5.1, C6.2, C7.1, C8.2, C9.1, C10.2, C11.1, C12.2, C13.1, C14.1, C15.2, C16.2, C19.1, C20.1, C21.1, C22.1, C23.1, C24.1, C25.1, C33.1, C34.2, C35.1, C36.2, C37.1, C38.2, C39.1, C40.2, C41.1, C42.2, C43.1, C44.1, C45.2, C46.1, C47.2, C55.2, C58.1, C59.1, C60.1, C61.1, C62.1, C63.1, C64.1, J1.2 (Ext), J2.2 (Ext), R3.1, R5.2, R16.1, R20.1, R22.2, R34.1, U6.5 (GND), U11.5 (GND)
unnamed: C1.2, R11.1, U3.3
unnamed: C2.1, R10.2, U4.3
unnamed: C16.1, C17.1, C18.2, R14.1, R15.2, U6.1 (NC)
unnamed: C17.2, J1.1 (In), R14.2
unnamed: C18.1, C19.2, R15.1, R16.2, U6.4 (NO)
unnamed: C20.2, C22.2, C24.2, U6.2 (V+)
unnamed: C21.2, C23.2, C25.2, U6.6 (V-)
unnamed: C26.1, C27.2, C28.1, C29.2, C31.1, C32.2
unnamed: C26.2, C28.2, C31.2, U5.5 (+VS)
unnamed: C27.1, C29.1, C32.1, U5.2 (-VS)
unnamed: C30.1, R17.2, U5.4 (-IN)
unnamed: C30.2, R2.2, R17.1, U5.1 (VOUT)
unnamed: C46.2, R28.1, U8.3
unnamed: C47.1, R27.2, U9.3
unnamed: C48.1, C49.2, C50.1, C51.2, C53.1, C54.2
unnamed: C48.2, C50.2, C53.2, U10.5 (+VS)
unnamed: C49.1, C51.1, C54.1, U10.2 (-VS)
unnamed: C52.1, R31.2, U10.4 (-IN)
unnamed: C52.2, R19.2, R31.1, U10.1 (VOUT)
unnamed: C55.1, C56.1, C57.2, R32.1, R33.2, U11.1 (NC)
unnamed: C56.2, J2.1 (In), R32.2
unnamed: C57.1, C58.2, R33.1, R34.2, U11.4 (NO)
unnamed: C59.2, C61.2, C63.2, U11.6 (V-)
unnamed: C60.2, C62.2, C64.2, U11.2 (V+)
unnamed: R1.1, U1.11 (VOCM2), U1.17 (VOCM1)
unnamed: R2.1, R6.2, U1.6 (IN2+)
unnamed: R3.2, R7.2, U1.7 (IN2-)
unnamed: R4.1, R8.2, U1.24 (IN1+)
unnamed: R5.1, R9.2, U1.1 (IN1-)
unnamed: R6.1, U1.5 (FB2-)
unnamed: R7.1, U1.8 (FB2+)
unnamed: R8.1, U1.23 (FB1-)
unnamed: R10.1, U1.13 (OUT2-)
unnamed: R11.2, U1.12 (OUT2+)
unnamed: R12.1, U3.1, U4.1
unnamed: R12.2, U1.19 (OUT1-)
unnamed: R13.1, U3.2, U4.2
unnamed: R9.1, R13.2, U1.2 (FB1+), U1.18 (OUT1+)
unnamed: R18.1, U7.11 (VOCM2), U7.17 (VOCM1)
unnamed: R19.1, R23.2, U7.6 (IN2+)
unnamed: R20.2, R24.2, U7.7 (IN2-)
unnamed: R21.1, R25.2, U7.24 (IN1+)
unnamed: R22.1, R26.2, U7.1 (IN1-)
unnamed: R23.1, U7.5 (FB2-)
unnamed: R24.1, U7.8 (FB2+)
unnamed: R25.1, U7.23 (FB1-)
unnamed: R26.1, R30.2, U7.2 (FB1+), U7.18 (OUT1+)
unnamed: R27.1, U7.13 (OUT2-)
unnamed: R28.2, U7.12 (OUT2+)
unnamed: R29.1, U8.1, U9.1
unnamed: R29.2, U7.19 (OUT1-)
unnamed: R30.1, U8.2, U9.2
unnamed: U5.3 (+IN), U6.8 (COM)
unnamed: U10.3 (+IN), U11.8 (COM)
Vcom: R1.2, R18.2

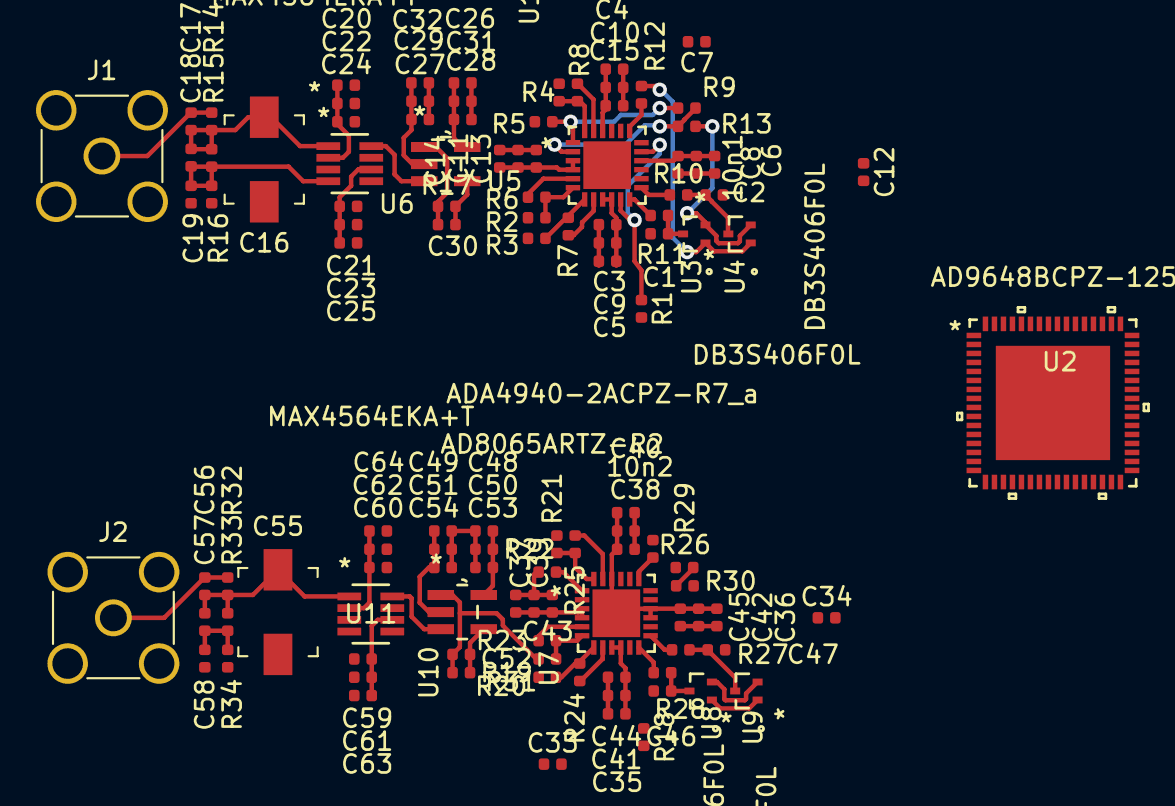
[picture p11: board FPGA_sequencer.kicad_pcb from above]

Board: 2 copper layers, 113 parts (0 on the bottom side), 58 nets.
