xecus/opensource-mri-project/PCB/Detector_rev2/Detector_rev2.kicad_pcb

## KiCad design PCB/Detector_rev2/Detector_rev2.kicad_pcb (2020-04-16)

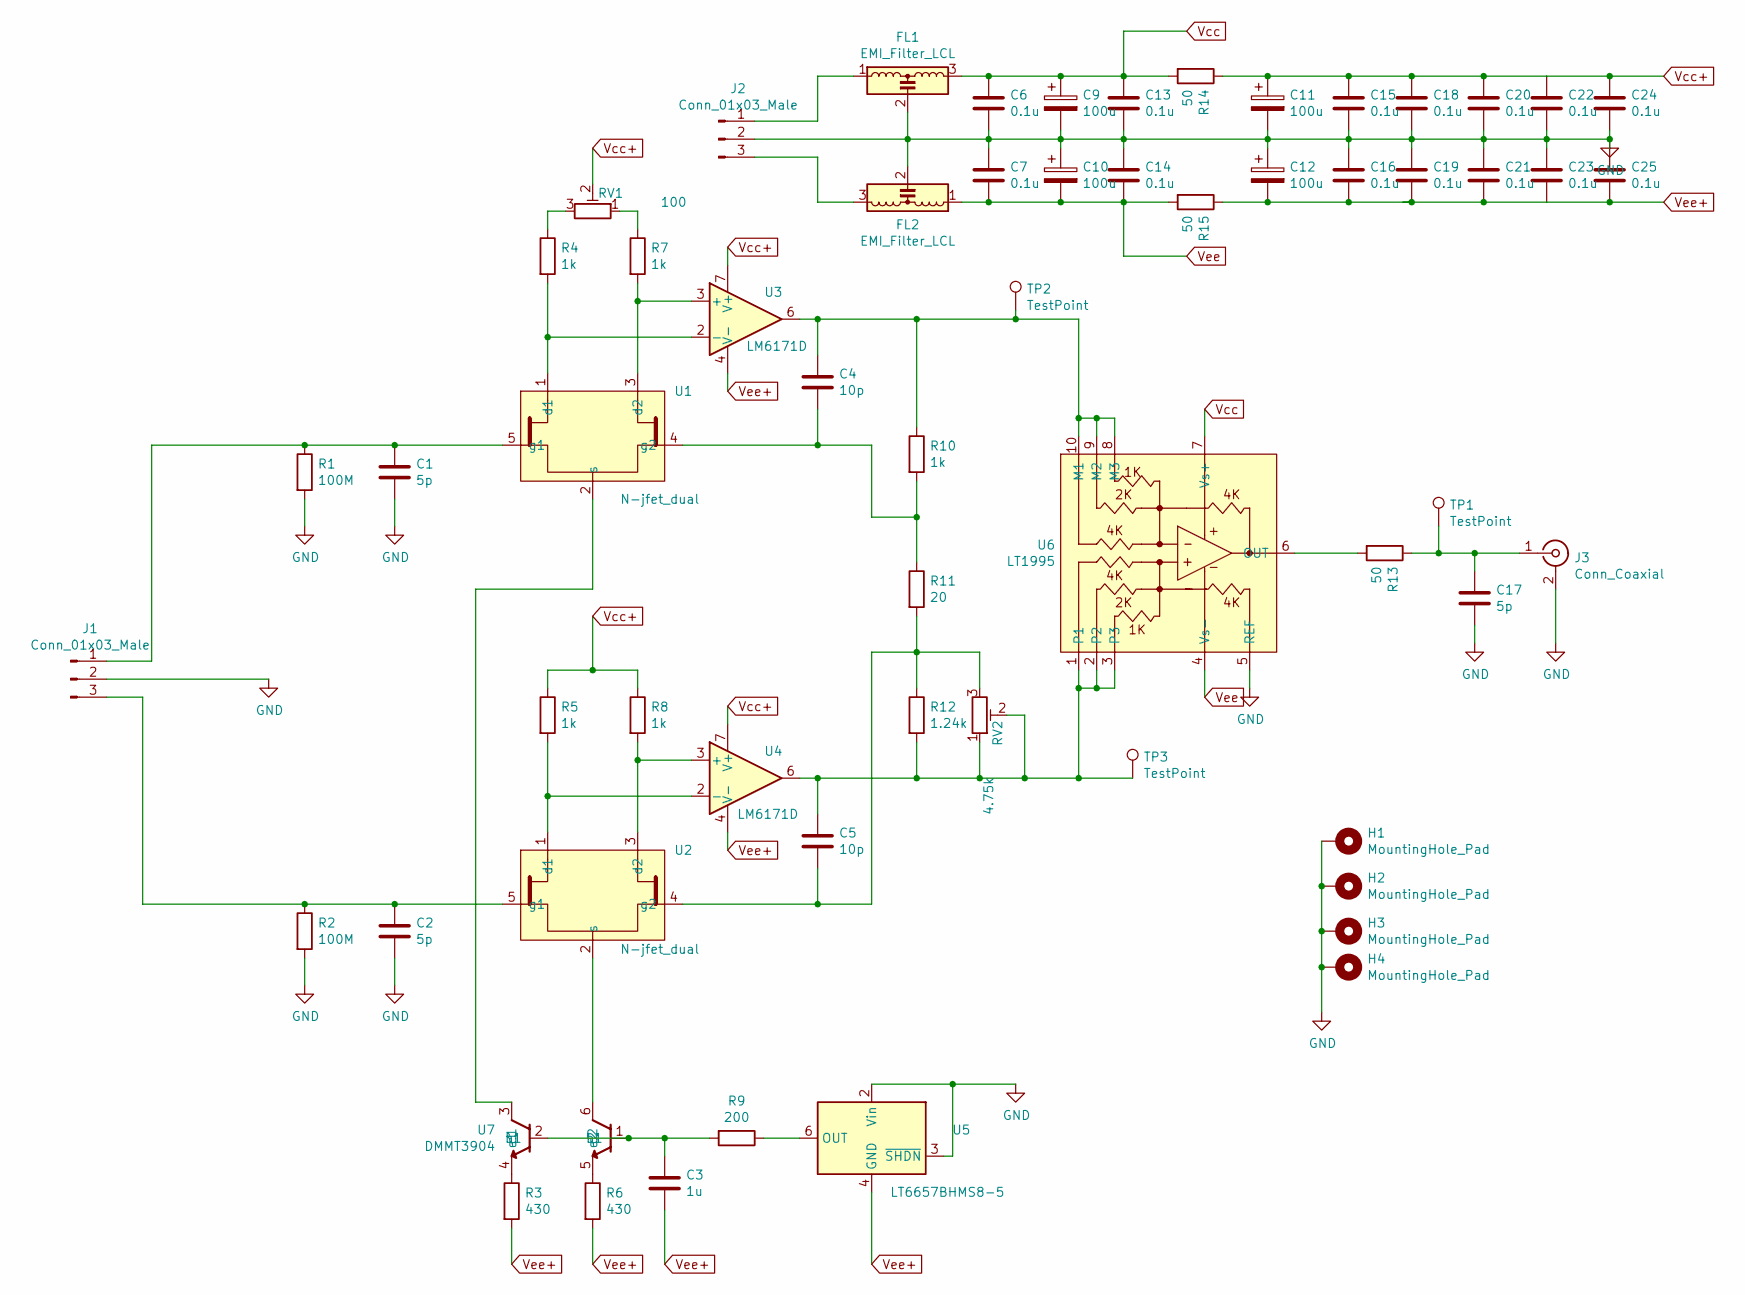
[picture p12: schematic Detector_rev2.sch]

Parts:
C1, C2, C17: 5p; C_0603_1608Metric
C3: 1u; C_0603_1608Metric
C4, C5: 10p; C_0603_1608Metric
C6, C7, C13, C14, C15, C16, C18, C19, C20, C21, C22, C23, C24, C25: 0.1u; C_0603_1608Metric
C9, C10, C11, C12: 100u; C_Elec_5x5.8
FL1, FL2: EMI_Filter_LCL; EMI_Filter_2606
H1, H2, H3, H4: MountingHole_Pad; MountingHole_2.7mm_Pad_Via
J1: Conn_01x03_Male; input
J2: Conn_01x03_Male; JST-XH_S3B
J3: Conn_Coaxial; SMA_Amphenol_132134_Vertical
R1, R2: 100M; R_0603_1608Metric
R3, R6: 430; R_0603_1608Metric
R4, R5, R7, R8, R10: 1k; R_0603_1608Metric
R9: 200; R_0603_1608Metric
R11: 20; R_0603_1608Metric
R12: 1.24k; R_0603_1608Metric
R13, R14, R15: 50; R_0603_1608Metric
RV1: 100; Potentiometer_Bourns_3269W_Vertical
RV2: 4.75k; Potentiometer_Bourns_3269W_Vertical
TP1, TP2, TP3: TestPoint; HK-1-G
U1, U2: N-jfet_dual; SOT_25
U3, U4: LM6171D; SOIC-8_3.9x4.9mm_P1.27mm
U5: LT6657BHMS8-5; MSOP-8_3x3mm_P0.65mm
U6: LT1995; MSOP-10_3x3mm_P0.5mm
U7: DMMT3904; SOT-363_SC-70-6

Connections:
GND: C1.2, C2.2, C6.2, C7.1, C9.2, C10.1, C11.2, C12.1, C13.2, C14.1, C15.2, C16.1, C17.2, C18.2, C19.1, C20.2, C21.1, C22.2, C23.1, C24.2, C25.1, FL1.2, FL2.2, H1.1, H2.1, H3.1, H4.1, J1.2, J2.2, J3.2 (Ext), R1.2, R2.2, U5.2 (Vin), U5.3 (~SHDN), U6.5 (REF)
unnamed: C1.1, J1.1, R1.1, U1.5 (g1)
unnamed: C2.1, J1.3, R2.1, U2.5 (g1)
unnamed: C3.2, R9.2, U7.1 (b1), U7.2 (b1)
unnamed: C4.1, R10.1, TP2.1, U3.6, U6.8 (M3), U6.9 (M2), U6.10 (M1)
unnamed: C4.2, R10.2, R11.1, U1.4 (g2)
unnamed: C5.1, R12.2, RV2.1, RV2.2, TP3.1, U4.6, U6.1, U6.2, U6.3
unnamed: C5.2, R11.2, R12.1, RV2.3, U2.4 (g2)
unnamed: C17.1, J3.1 (In), R13.1, TP1.1
unnamed: FL1.1, J2.1
unnamed: FL2.3, J2.3
unnamed: R3.1, U7.4 (e1)
unnamed: R4.1, RV1.3
unnamed: R4.2, U1.1 (d1), U3.2 (-)
unnamed: R5.2, U2.1 (d1), U4.2 (-)
unnamed: R6.1, U7.5 (e2)
unnamed: R7.1, RV1.1
unnamed: R7.2, U1.3 (d2), U3.3 (+)
unnamed: R8.2, U2.3 (d2), U4.3 (+)
unnamed: R9.1, U5.6 (OUT)
unnamed: R13.2, U6.6 (OUT)
unnamed: U1.2 (s), U7.3 (c1)
unnamed: U2.2 (s), U7.6 (c2)
Vcc: C6.1, C9.1, C13.1, FL1.3, R14.2, U6.7 (Vs+)
Vcc+: C11.1, C15.1, C18.1, C20.1, C22.1, C24.1, R5.1, R8.1, R14.1, RV1.2, U3.7 (V+), U4.7 (V+)
Vee: C7.2, C10.2, C14.2, FL2.1, R15.2, U6.4 (Vs-)
Vee+: C3.1, C12.2, C16.2, C19.2, C21.2, C23.2, C25.2, R3.2, R6.2, R15.1, U3.4 (V-), U4.4 (V-), U5.4 (GND)

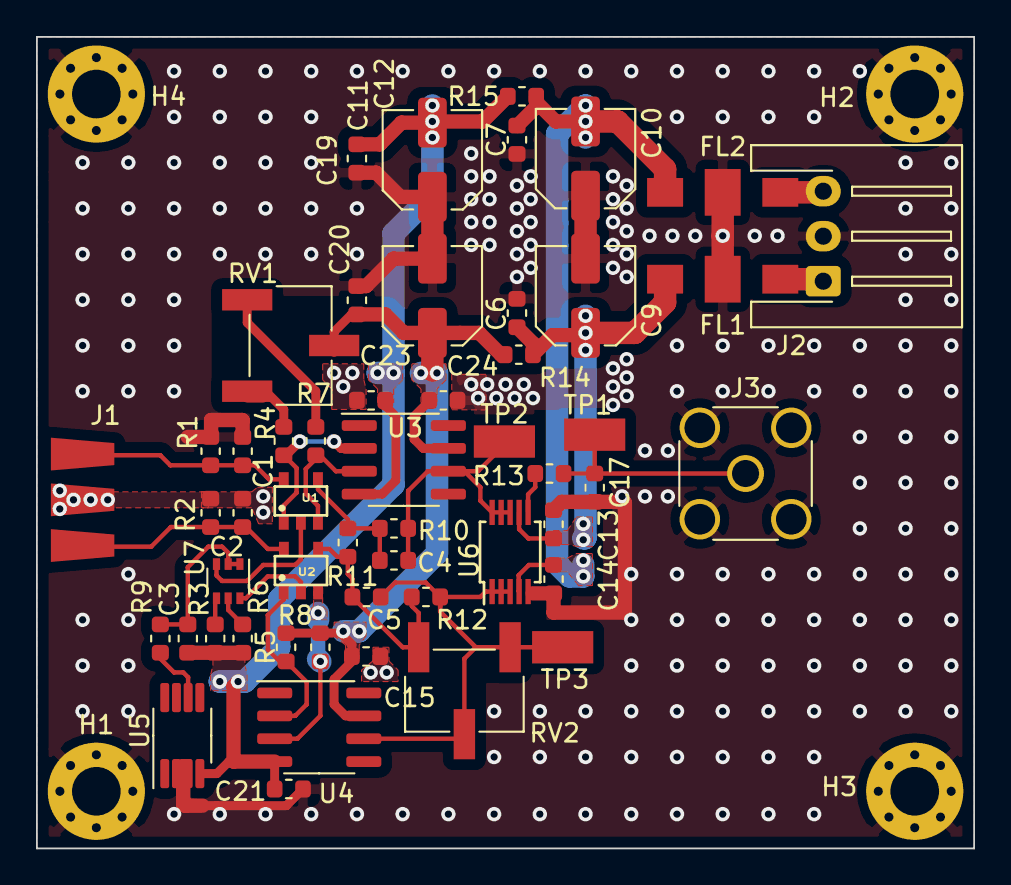
[picture p13: board Detector_rev2.kicad_pcb from above]

Board: 2 copper layers, 52.1 x 45.1 mm, 56 parts (0 on the bottom side), 27 nets.
