xecus/opensource-mri-project/PCB/GradientCoil_transverse/GradientCoil_XY.kicad_pcb

## KiCad design PCB/GradientCoil_transverse/GradientCoil_XY.kicad_pcb (2020-04-10)

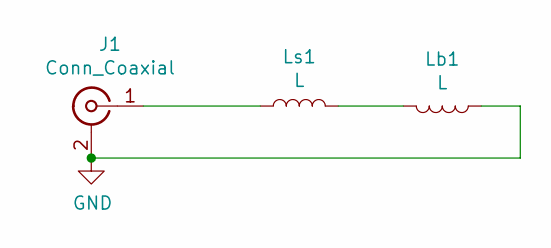
[picture p14: schematic GradientCoil_XY.sch]

Parts:
J1: Conn_Coaxial; SMA_Amphenol_132134-16_Vertical
Lb1: L; GC_XY_bottom_r6
Ls1: L; GC_XY_surf_r1

Connections:
GND: J1.2 (Ext), Lb1.1
unnamed: J1.1 (In), Ls1.1
unnamed: Lb1.2, Ls1.2

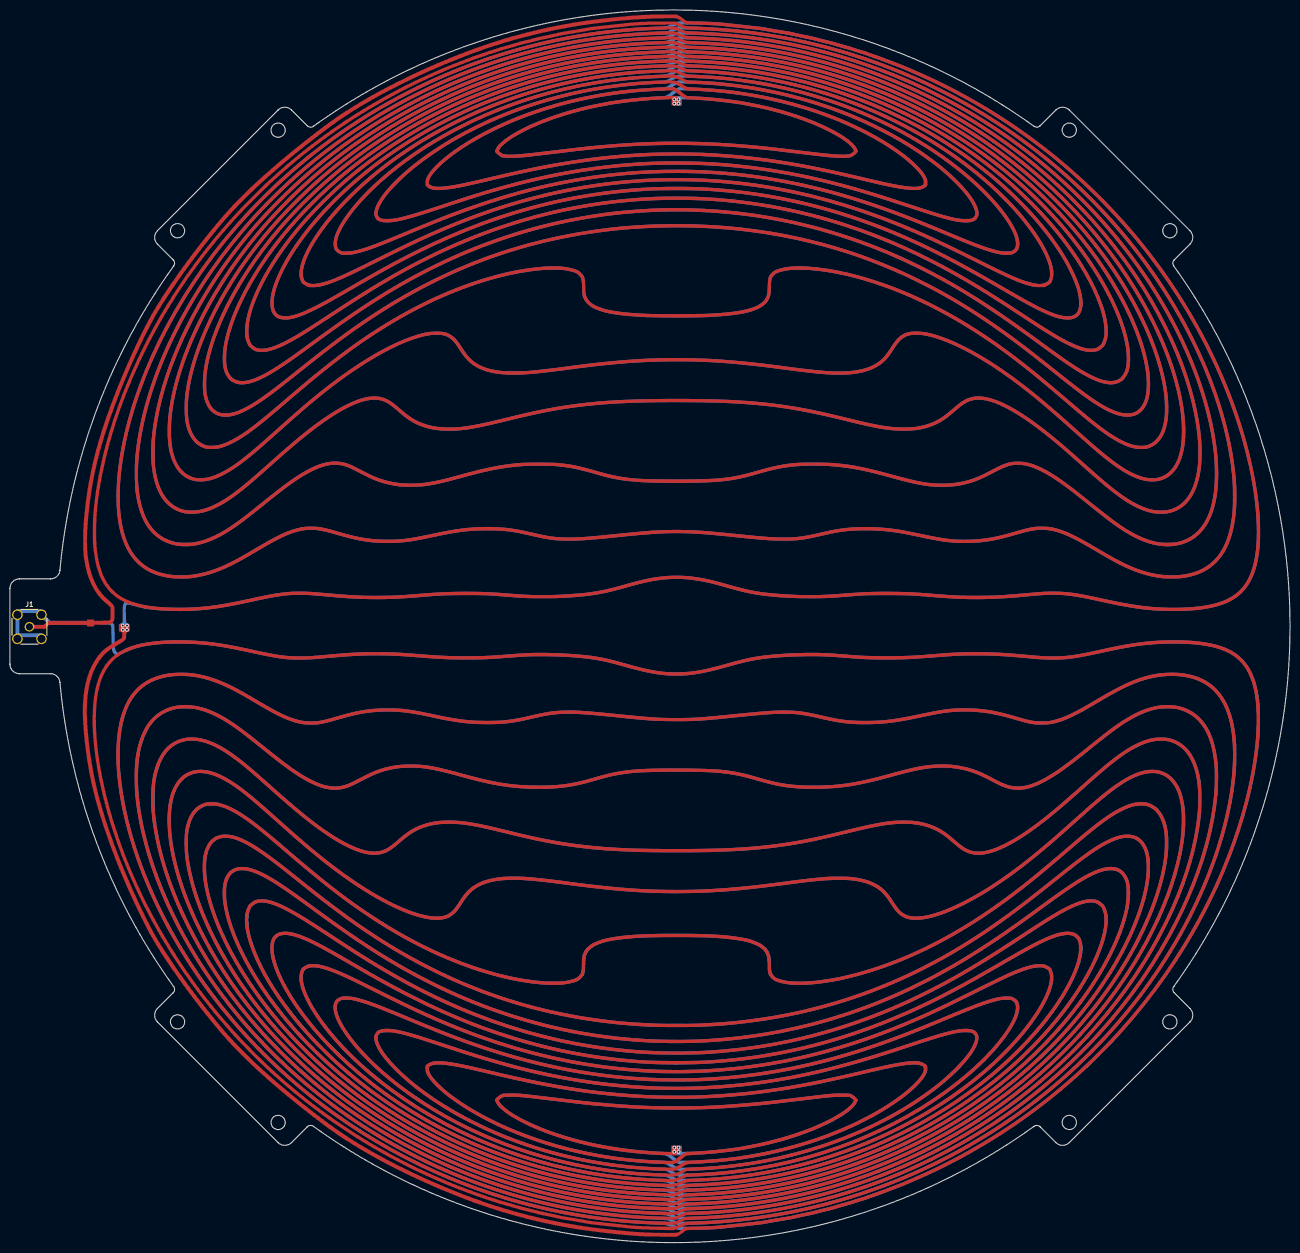
[picture p15: board GradientCoil_XY.kicad_pcb from above]

Board: 2 copper layers, 270.0 x 260.0 mm, 3 parts (0 on the bottom side), 3 nets.
