xecus/opensource-mri-project/(commit log)

2020-04-10 横方向勾配コイルフォルダの作成
2020-04-10 Update and rename Detector to PCB_note
2020-04-11 pass capacitor add
    [FPGA_sequencer.kicad_pcb, FPGA_sequencer.sch]
2020-04-12 AD8065 add
    [FPGA_sequencer.sch]
2020-04-12 MAX4565 Analog switch add
    [FPGA_sequencer.kicad_pcb, FPGA_sequencer.sch]
2020-04-13 input terminal adjust
    [Detector_rev2.kicad_pcb]
2020-04-14 garberdata output
    [Detector_rev2-B_Cu.gbl, Detector_rev2-B_Mask.gbs, Detector_rev2-B_Paste.gbp, Detector_rev2-B_SilkS.gbo, Detector_rev2-Edge_Cuts.gm1, Detector_rev2-F_Cu.gtl, Detector_rev2-F_Mask.gts, Detector_rev2-F_Paste.gtp]
2020-04-16 ADC driver pattern write
    [Detector_rev2.kicad_pcb, FPGA_sequencer.kicad_pcb, FPGA_sequencer.sch]
2020-05-16 Current Controller and GradientDriver_rev2
    [Connector_Array_A_type.kicad_pcb, Connector_Array_A_type.sch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]
2020-05-16 GradDriver rev2 edit
    [GradientDriver.kicad_pcb]
